cosmic-pi-deprecated/Version2-HARDWARE/README.md

# Version2-HARDWARE
A single board version of Cosmic Pi building on the V2.5 analogue + main boards.
