cosmic-pi-deprecated/Version2-HARDWARE/BOM master with extended info.xlsx

Designator | Manufacturer Part Number | Quantity | Alternative | Comments | Package | Value | Voltage | Tolerance
SIPM1X1_BOT, SIPM1X1_TOP | ASD-NUV1S-P | 2 | ASD-NUV1C-P | DNP | DIODE_ASD-NUV1S-P
SIPM3X3_BOT, SIPM3X3_TOP | ASD-NUV3S-P | 2 |  | DNP | DIODE_ASD-NUV3S-P
R31 | RC0603JR-070RL | 1 |  |  | R0603 | 0 |  | N/A
R9 | RC1206JR-070RL | 1 |  |  | R1206 | 0 |  | N/A
L1 | 744235601 | 1 |  |  | WE-CNSW_1812 | 1 uH CM choke
R30, R66, R75 | RC0603JR-0710RL | 3 |  |  | R0603 | 10 |  | 5%
R64, R73 | RC0603JR-07100RL | 2 |  |  | R0603 | 100 |  | 5%
R5, R25, R40, R41, R56, R57, R60, R61 | RC0603FR-07100KL | 8 |  |  | R0603 | 100k |  | 1%
C9, C10, C14, C15, C19, C20, C24, C25, C29, C32, C33, C34, C35, C36, C38, C41, C44, C50, C53, C56, C57, C58, C59, C61, C65, C66, C73, C74, C76, C80, C81, C82, C84, C85, C86, C88, C90, C91, C92, C93, C94 | CC0603KRX7R9BB104 | 41 |  |  | C0603 | 100n | 50V
C1, C16 | ECP-U1C104MA5 | 2 |  |  | C0805 | 100n ECPU | 16V
C6 | TAJC107K010RNJ | 1 |  |  | C/6032-28R | 100u | 10V
USB1 | 10118193-0001LF | 1 |  |  | MICRO-USB5+6P-SMD-0.65-B | 10118193-0001LF
R4, R32, R67, R68 | ERA-6AEB103V | 4 |  |  | R0805 | 10K |  | 0.10%
R13, R14 | RC0603FR-0710KL | 2 |  |  | R0603 | 10K |  | 1%
R23, R29, R38, R39, R43, R53, R54, R55, R58, R59, R62, R63 | RC0603FR-0710KL | 12 |  |  | R0603 | 10k |  | 1%
C5, C8, C37, C39, C42, C51, C54, C60, C62, C48 | CC0603KRX7R9BB103 | 10 |  |  | C0603 | 10n | 50V
C26, C28, C67, C68 | CC0603KRX5R6BB106 | 4 |  |  | C0603 | 10u | 10V
C45, C47 | TAJA106K016RNJ | 2 |  |  | AVX | 10u | 16V
L11 | SRR0604-100ML | 1 |  |  | SRR0604 | 10u SRR0604-100ML
X4, X5 | 20021121-00008C4LF | 2 |  |  | 1296-08 | 1296-T08
L2, L9 | CM453232-151KL | 2 |  |  | L1812 | 150uH
R17, R26 | RC0603FR-071KL | 2 |  |  | R0603 | 1K |  | 1%
R21, R49 | RC0603FR-071ML | 2 |  |  | R0603 | 1M |  | 1%
R71, R77 | RC0603FR-071KL | 2 |  |  | R0603 | 1k |  | 1%
R1, R2, R15, R16 | RC1206FR-071KL | 4 |  |  | R1206 | 1k |  | 1%
C43, C49, C63, C64, C72, C75 | CC0603KRX7R9BB102 | 6 |  |  | C0603 | 1n | 50V
C7, C13, C83, C95 | CC0603KRX7R8BB105 | 4 |  |  | C0603 | 1u | 25V
C2, C3, C21, C22 | CL31B105KCHNNNE | 4 |  |  | C1206 | 1u | 100V
C11 | CC0603KRX7R6BB225 | 1 |  |  | C0603 | 2.2u | 10V
R7, R8 | RC0603JR-0720RL | 2 |  |  | R0603 | 20 |  | 5%
R42, R52 | RC0603JR-07200KL | 2 |  |  | R0603 | 200k |  | 5%
C77, C78 | CL10C200JB8NNNC | 2 |  |  | C0603 | 20p | 50V
C40, C52, C55 | CC0603KRX7R8BB224 | 3 |  |  | C0603 | 220n | 25V
IC11 | 24LC00T-I/OT | 1 |  |  | SOT23-5L | 24C00OT
X2 | GX531S-8.000KKF1001 | 1 |  |  | X5032_4P | 306010032_XTAL_8MHZ_5032_4P
R18, R27 | RC0603FR-0730KL | 2 |  |  | R0603 | 30K |  | 1%
C4, C17 | 06031A300J4T2A | 2 |  |  | C0603 | 30p NP0 | 100V
CPU, PSU | STM32F401RET6 | 2 |  |  | LQFP64 | 310010495_STM32F401RET6
R11, R50 | RC0603FR-0730KL | 2 |  |  | R0603 | 32.4k |  | 1%
R3, R22, R34, R35, R45 | RC0603FR-07330RL | 5 |  |  | R0603 | 330 |  | 1%
R36, R37 | RC0603FR-07330RL | 2 |  |  | R0603 | 330R |  | 1%
C27, C71, C79, C87, C89 | CC0603KRX5R6BB475 | 5 |  |  | C0603 | 4.7u | 10V
C12, C46 | CC0402KRX7R8BB473 | 2 |  |  | C0603 | 47n | 25V
L3 | B82496C3470J000 | 1 |  |  | INDC1608X90N | 47nH
PC1, PC2 | EEE-HA1E470WP | 2 |  |  | PANASONIC_D | 47u | 25V
J3, J4, J5 | 5-1814400-1 | 3 |  | Bottom side | TE_5-1814400-1 | 5-1814400-1
R65, R74 | CRCW0603499KFKEA | 2 |  | Actually 499k | R0603 | 500k |  | 1%
R24, R28 | RC0603FR-07510RL | 2 |  |  | R0603 | 5100 |  | 1%
R19 | RC0603JR-0751KL | 1 |  |  | R0603 | 51K |  | 5%
L4, L5, L6, L7, L8 | 74279218 | 5 |  |  | 1206 | 600R/100MHz
IC7, IC8, IC9 | SN74LVC1G00DBVR | 3 |  |  | SOT23-5 | SN74LVC1G00DBVR
R10, R12, R20, R47 | CRCW0603820RFKEA | 4 |  |  | R0603 | 820 |  | 1%
IC1, IC2, IC10 | AD8039ARZ | 3 |  |  | SO8 | AD8039
D3, D4 | BAS70-04-E3-08 | 2 |  |  | SOT23 | BAS70-04
D13, D14 | BAT46WH | 2 |  |  | SOD123F | BAT46WH
D10, D12 | BL-HB337A-AV-TRB | 2 |  | Any 0402 blue LED is ok. | LED-0402 | BLUE-0402
D1 | 19-217-BHC-ZL1M2RY-3T | 1 |  | Any 0603 blue LED is ok. | LED-0603 | BLUE-0603
Q1, Q2 | BSS123-7-F | 2 |  |  | SOT23 | BSS123
D6 | CD1206-S01575 | 1 |  |  | MINIMELF | CD1206-S01575
J6 | M20-7871042 | 1 | 2-969973-0 | Top side | 2X20_SHROUDED_SMT | CONN_20X2SHROUDED_SMT
D9, D11 | 19-217-G7C-AN1P2-3T | 2 |  | Any 0603 green LED is ok | LED-0603 | GREEN-0603
U1 | L76-M33 | 1 |  | Supplier - RS | CAPCAV110P970X1010X250-18N | L76-M33
IC13 | LM2734YMK/NOPB | 1 |  |  | SOT23-6 | LM2734Y
IC4, IC5, IC6 | TLC555ID | 3 |  |  | SO08 | LM555D
IC3 | LP2985IM5-3.1 | 1 |  |  | SOT95P284X120-5N | LP2985IM5-3.1
IC14 | LPS25HBTR | 1 |  |  | LPS25H | LPS25H
IC16 | LSM303DTR | 1 |  |  | LGA16L | LSM303D
IC$3 | MAX991ESA+ | 1 |  |  | SOIC-8 | MAX991ESA+
U3, U4 | MCP4725A0T-E/CH | 2 |  |  | SOT23-6 | MCP4725
L10 | MH2029-300Y | 1 |  |  | 805 | MH2029-300Y
IC12 | NCP1117ST33T3G | 1 |  |  | SOT223 | NCP1117ST33T3G -3V3
X1 | DC-005 | 1 |  | Bottom side | POWERSUPPLY_DC-21MM | POWERSUPPLY_DC21MMX
IC15 | Si7006-A20-IM1 | 1 |  |  | 3X3DFN | SI7006A20
D7, D8, D15 | SS1P3L-M3/84A | 3 |  |  | DO220AAL | SS1P3L
IC17 | UCC27528D | 1 |  |  | ANALOG-DEVICES_SO8 | UCC27528UCC27528DR
