cosmic-pi-deprecated/Version2-HARDWARE/Cosmic Pi V2.pdf

# Signal

# +4V Regulated Power Supply

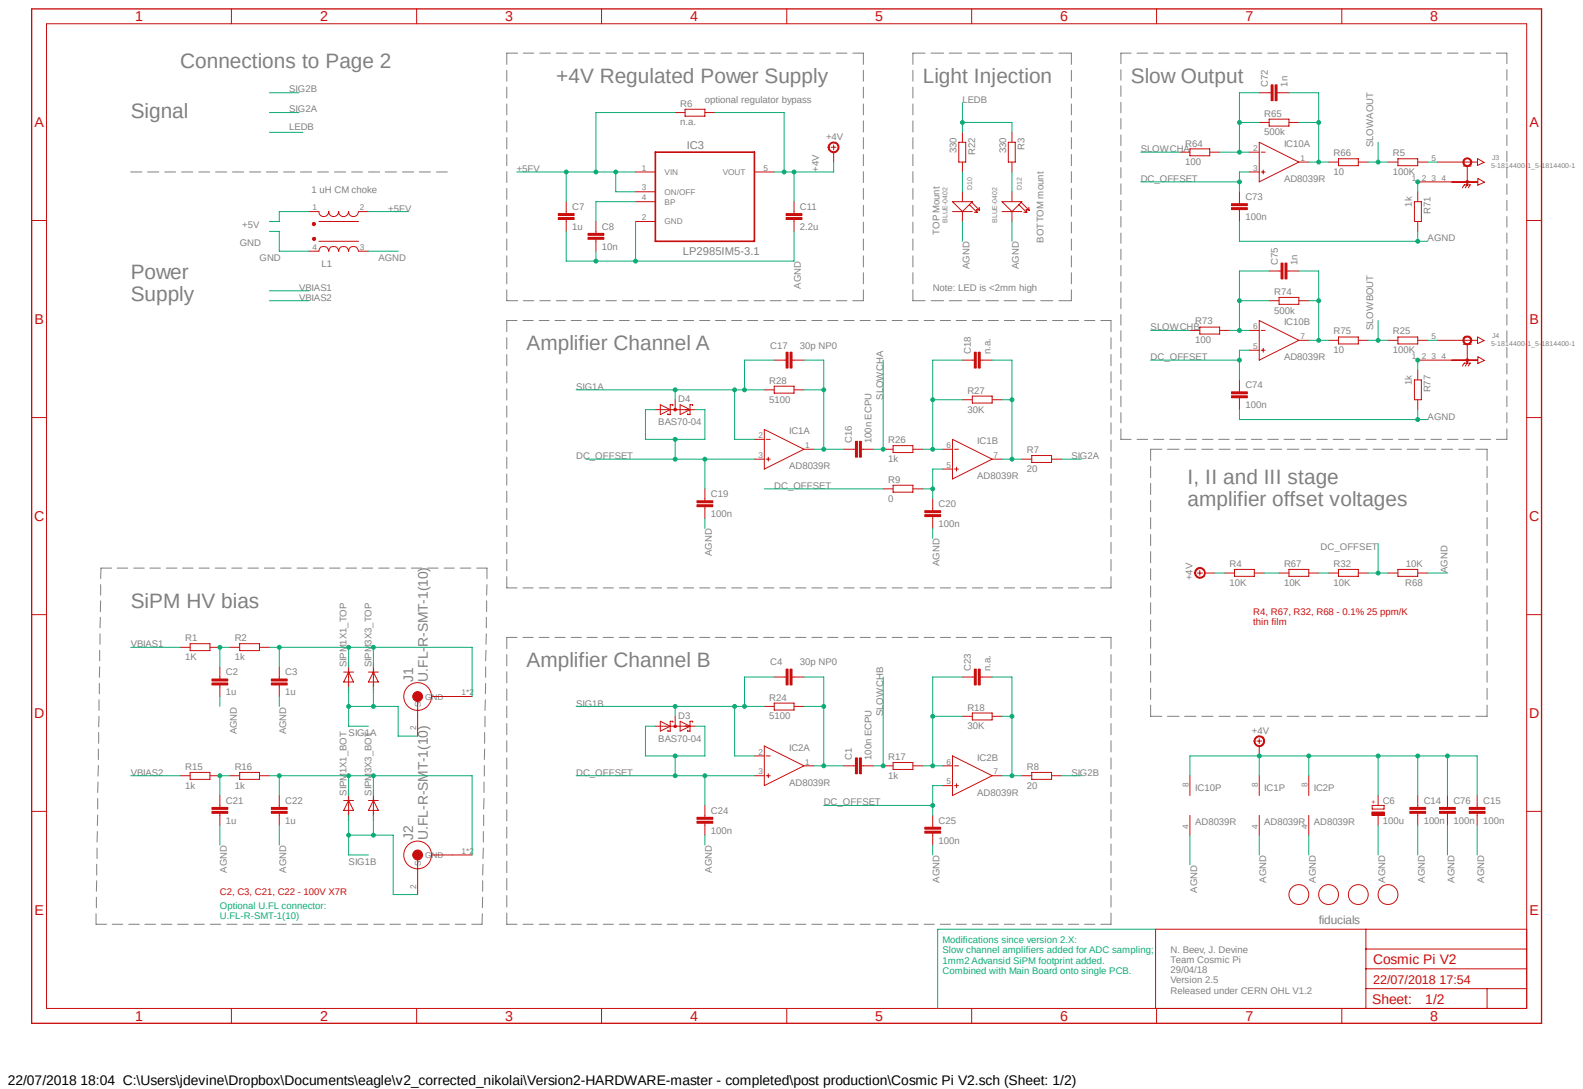
[picture p1: page 1]

I, II and III stage
amplifier offset voltages

U.FL-R-SMT-1(10)

22/07/2018 18:04 C:\Users\jdevine\Dropbox\Documents\eagle\v2_corrected_nikolai\Version2-HARDWARE-master - completed\post production\Cosmic Pi V2.sch (Sheet: 1/2) SpiceOrder 1 SpiceOrder 2 SpiceOrder 1 SpiceOrder 2 SpiceOrder 1 SpiceOrder 2 SpiceOrder 1 SpiceOrder 2

fiducials

Modifications since version 2.X:
Slow channel amplifiers added for ADC sampling;
1mm2 Advansid SiPM footprint added.
Combined with Main Board onto single PCB.

N. Beev, J. Devine Team Cosmic Pi 29/04/18 Version 2.5 Released under CERN OHL V1.2

Sheet: 1/2

A

A

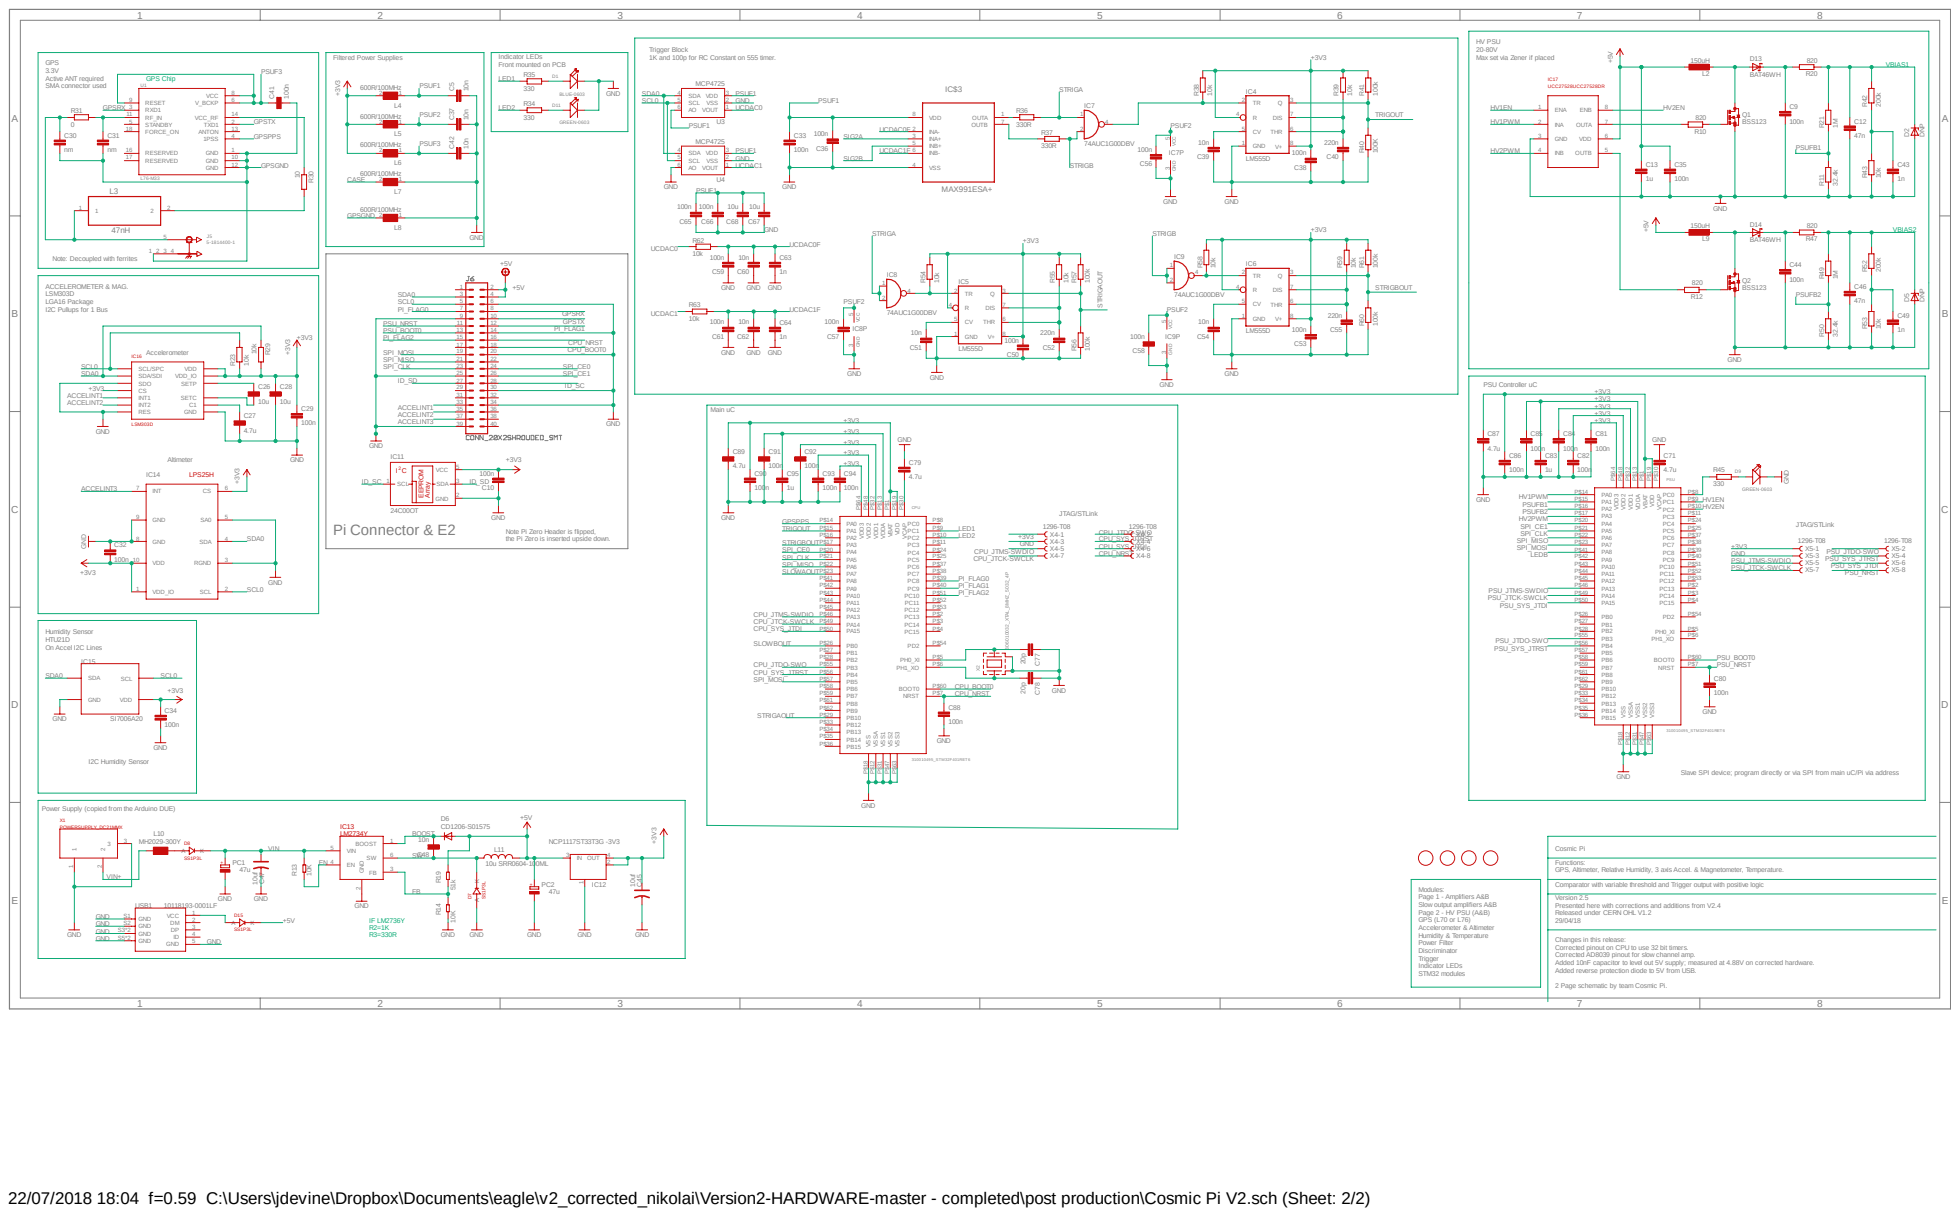
[picture p2: page 2]

HV PSU
Max set via Zener if placed

Indicator LEDs
Front mounted on PCB
LED1

Note: Decoupled with ferrites

GND
Note Pi Zero Header is flipped,
the Pi Zero is inserted upside down.

Slave SPI device; program directly or via SPI from main uC/Pi via address

Power Supply (copied from the Arduino DUE)

Cosmic Pi
Functions:
GPS, Altimeter, Relative Humidity, 3 axis Accel. & Magnetometer, Temperature.

Comparator with variable threshold and Trigger output with positive logic
Version 2.5
Presented here with corrections and additions from V2.4
Released under CERN OHL V1.2

Changes in this release:
Corrected pinout on CPU to use 32 bit timers.
Corrected AD8039 pinout for slow channel amp.
Added 10nF capacitor to level out 5V supply; measured at 4.88V on corrected hardware.
Added reverse protection diode to 5V from USB.

2 Page schematic by team Cosmic Pi.

22/07/2018 18:04 f=0.59 C:\Users\jdevine\Dropbox\Documents\eagle\v2_corrected_nikolai\Version2-HARDWARE-master - completed\post production\Cosmic Pi V2.sch (Sheet: 2/2)
