cosmic-pi-deprecated/Version2-HARDWARE/Cosmic Pi V2.brd

## EAGLE design Cosmic Pi V2.brd (2018-07-22)

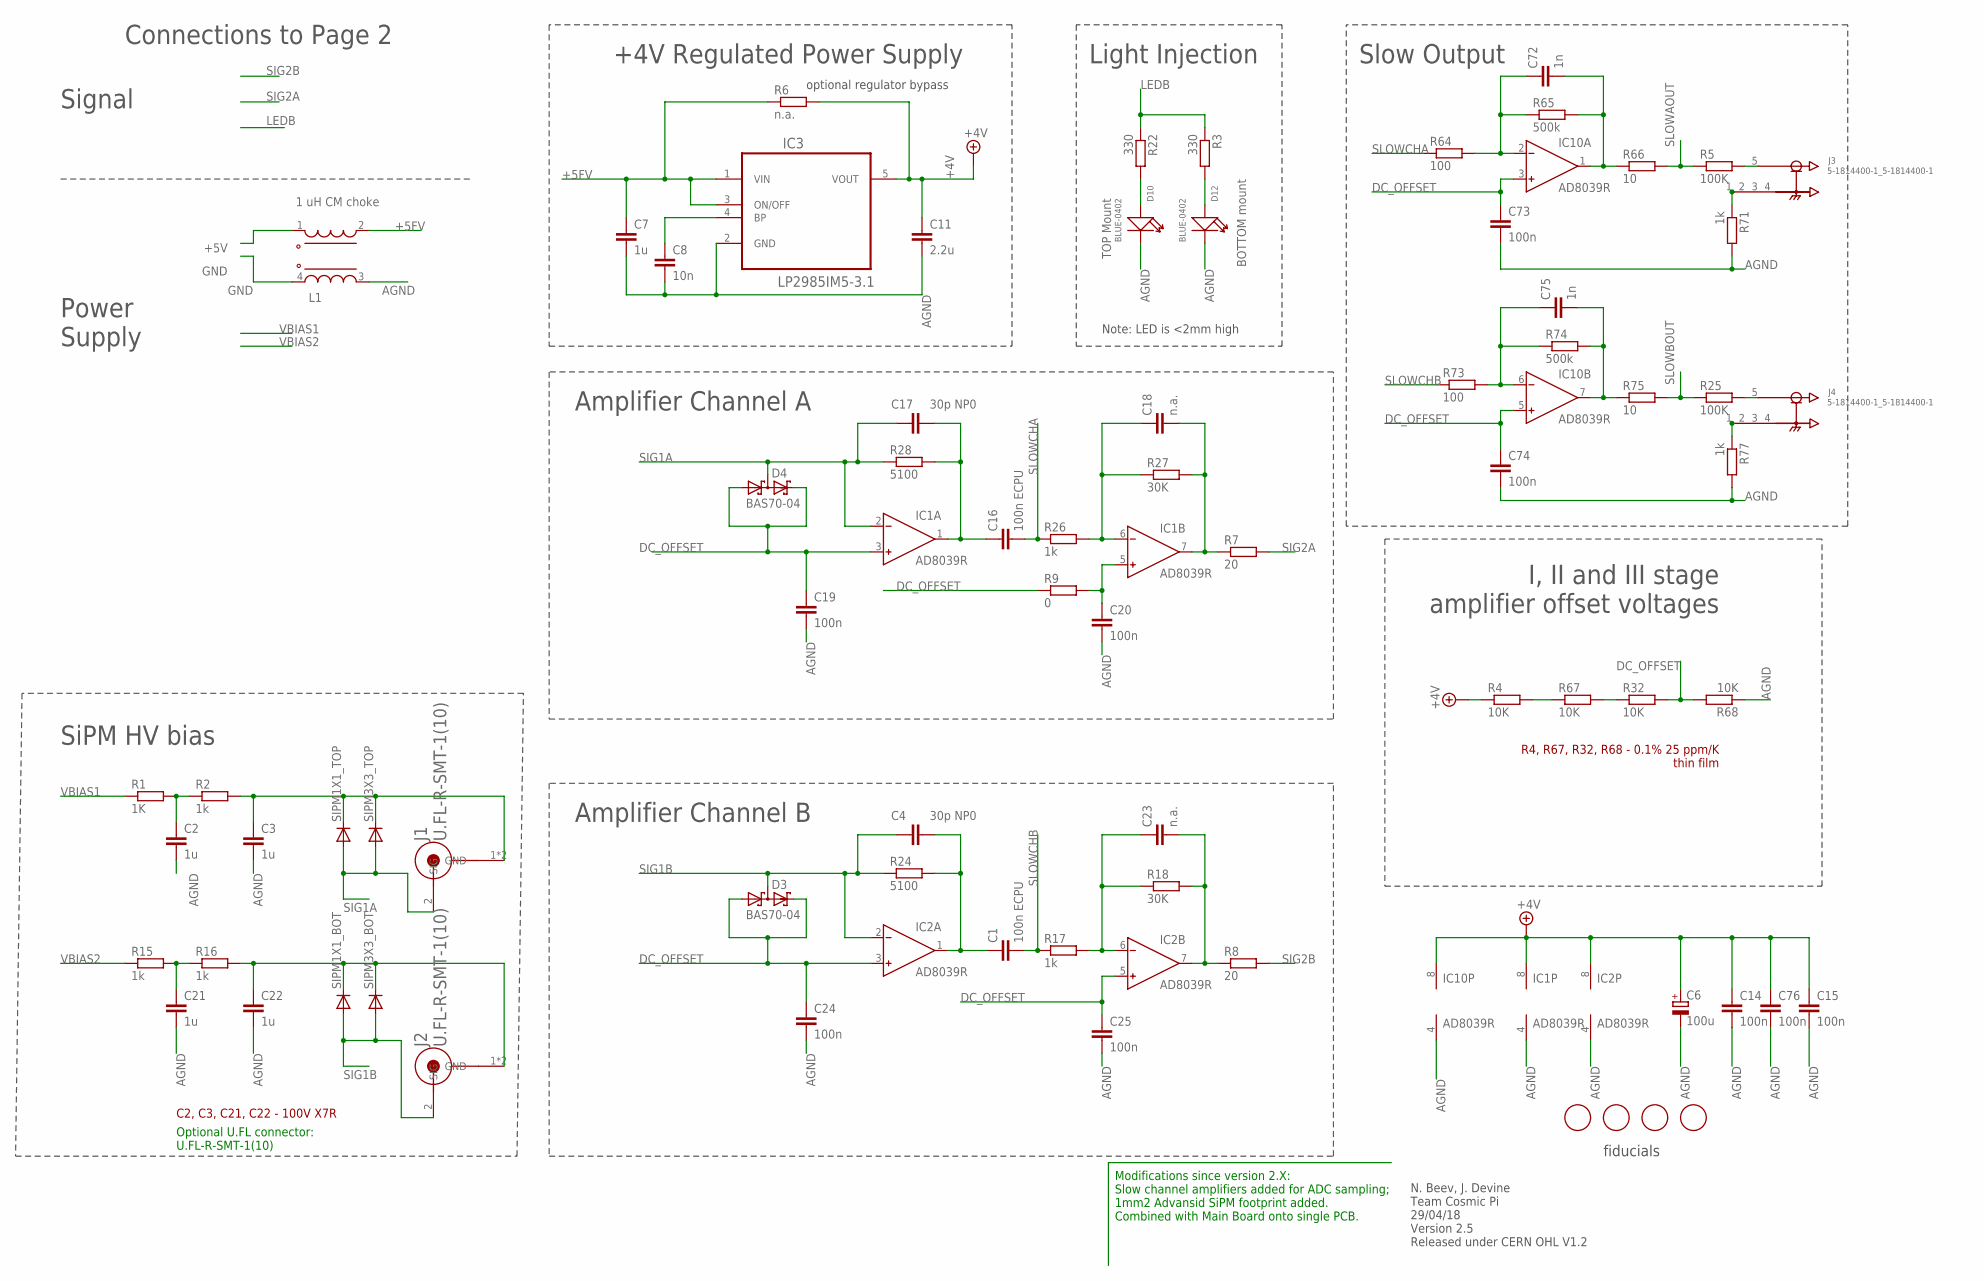
[picture p3: schematic Cosmic Pi V2.sch, sheet 1]

Parts:
C1, C16: 100n ECPU; C0805
C2, C3, C21, C22: 1u; C1206
C4, C17: 30p NP0; C0603
C6: 100u; C/6032-28R
C7: 1u; C0603
C8: 10n; C0603
C11: 2.2u; C0603
C14, C15, C19, C20, C24, C25, C73, C74, C76: 100n; C0603
C18, C23: n.a.; C0603
C72, C75: 1n; C0603
D3, D4: BAS70-04; SOT23
D10, D12: BLUE-0402; LED-0402
IC1, IC2, IC10: AD8039R; SO8
IC3: LP2985IM5-3.1; SOT95P284X120-5N
J1, J2: U.FL-R-SMT-1(10); HRS_U.FL-R-SMT-1(10)
J3, J4: 5-1814400-1_5-1814400-1; 5-1814400-1_TE_5-1814400-1
L1: 1 uH CM choke; WE-CNSW_1812
R1: 1K; R1206
R2, R15, R16: 1k; R1206
R3, R22: 330; R0603
R4, R32, R67, R68: 10K; R0805
R5, R25: 100K; R0603
R6: n.a.; R0603
R7, R8: 20; R0603
R9: 0; R1206
R17, R26, R71, R77: 1k; R0603
R18, R27: 30K; R0603
R24, R28: 5100; R0603
R64, R73: 100; R0603
R65, R74: 500k; R0603
R66, R75: 10; R0603
SIPM1X1_BOT, SIPM1X1_TOP: DIODE_DIODE-ADVANSID1X1; DIODE_ASD-NUV1S-P
SIPM3X3_BOT, SIPM3X3_TOP: DIODE_DIODE-ADVANSID3X3; DIODE_ASD-NUV3S-P
U$2, U$3, U$4, U$5: FIDUCIAL; FIDUCIAL_1MM

Connections:
+4V: C6.+, C11.1, C14.1, C15.1, C76.1, IC1.8 (V+), IC2.8 (V+), IC3.5 (VOUT), IC10.8 (V+), R4.1, R6.2
+5FV: C7.1, IC3.1 (VIN), IC3.3 (ON/OFF), L1.2 (3), R6.1
+5V: L1.1 (4); also elsewhere on the board
AGND: C2.2, C3.2, C6.-, C7.2, C8.2, C11.2, C14.2, C15.2, C19.2, C20.2, C21.2, C22.2, C24.2, C25.2, C73.2, C74.2, C76.2, D10.-, D12.-, IC1.4 (V-), IC2.4 (V-), IC3.2 (GND), IC10.4 (V-), L1.3 (2), R68.1, R71.2, R77.2
DC_OFFSET: C19.1, C24.1, C25.1, C73.1, C74.1, D3.1 (A1), D3.2 (C2), D4.1 (A1), D4.2 (C2), IC1.3 (IN+), IC2.3 (IN+), IC2.5 (IN+), IC10.3 (IN+), IC10.5 (IN+), R9.1, R32.2, R68.2
GND: L1.4 (1); also elsewhere on the board
LEDB: R3.1, R22.1; also elsewhere on the board
unnamed: J3.5 (SIG), R5.2
unnamed: R4.2, R67.1
unnamed: D12.+, R3.2
unnamed: C8.1, IC3.4 (BP)
unnamed: C21.1, R15.2, R16.1
unnamed: C18.2, IC1.7 (OUT), R7.1, R27.2
unnamed: C22.1, J2.1 (GND), J2.3 (GND), R16.2, SIPM1X1_BOT.P$1 (C), SIPM3X3_BOT.P$1 (C)
unnamed: J4.5 (SIG), R25.2
unnamed: C23.2, IC2.7 (OUT), R8.1, R18.2
unnamed: C2.1, R1.2, R2.1
unnamed: C72.1, IC10.2 (IN-), R64.2, R65.1
unnamed: C20.1, IC1.5 (IN+), R9.2
unnamed: C3.1, J1.1 (GND), J1.3 (GND), R2.2, SIPM1X1_TOP.P$1 (C), SIPM3X3_TOP.P$1 (C)
unnamed: D10.+, R22.2
unnamed: R32.1, R67.2
unnamed: C1.1, C4.2, IC2.1 (OUT), R24.2
unnamed: J4.1 (GND), R77.1
unnamed: C23.1, IC2.6 (IN-), R17.2, R18.1
unnamed: C16.1, C17.2, IC1.1 (OUT), R28.2
unnamed: C72.2, IC10.1 (OUT), R65.2, R66.1
unnamed: C18.1, IC1.6 (IN-), R26.2, R27.1
unnamed: C75.1, IC10.6 (IN-), R73.2, R74.1
unnamed: J3.1 (GND), R71.1
unnamed: C75.2, IC10.7 (OUT), R74.2, R75.1
SIG1A: C17.1, D4.3 (C1A2), IC1.2 (IN-), J1.2 (SIG), R28.1, SIPM1X1_TOP.P$2 (A), SIPM3X3_TOP.P$2 (A)
SIG1B: C4.1, D3.3 (C1A2), IC2.2 (IN-), J2.2 (SIG), R24.1, SIPM1X1_BOT.P$2 (A), SIPM3X3_BOT.P$2 (A)
SIG2A: R7.2; also elsewhere on the board
SIG2B: R8.2; also elsewhere on the board
SLOWAOUT: R5.1, R66.2; also elsewhere on the board
SLOWBOUT: R25.1, R75.2; also elsewhere on the board
SLOWCHA: C16.2, R26.1, R64.1
SLOWCHB: C1.2, R17.1, R73.1
VBIAS1: R1.1; also elsewhere on the board
VBIAS2: R15.1; also elsewhere on the board

Notes on the sheet:
N. Beev, J. Devine Team Cosmic Pi 29/04/18 Version 2.5 Released under CERN OHL V1.2
Signal
Power Supply
Note: LED is <2mm high
+4V Regulated Power Supply
Amplifier Channel A
Amplifier Channel B
SiPM HV bias
optional regulator bypass
Light Injection
I, II and III stage amplifier offset voltages
fiducials
R4, R67, R32, R68 - 0.1% 25 ppm/K thin film
C2, C3, C21, C22 - 100V X7R
Optional U.FL connector: U.FL-R-SMT-1(10)
Modifications since version 2.X: Slow channel amplifiers added for ADC sampling; 1mm2 Advansid SiPM footprint added. Combined with Main Board onto single PCB.
Connections to Page 2
Slow Output

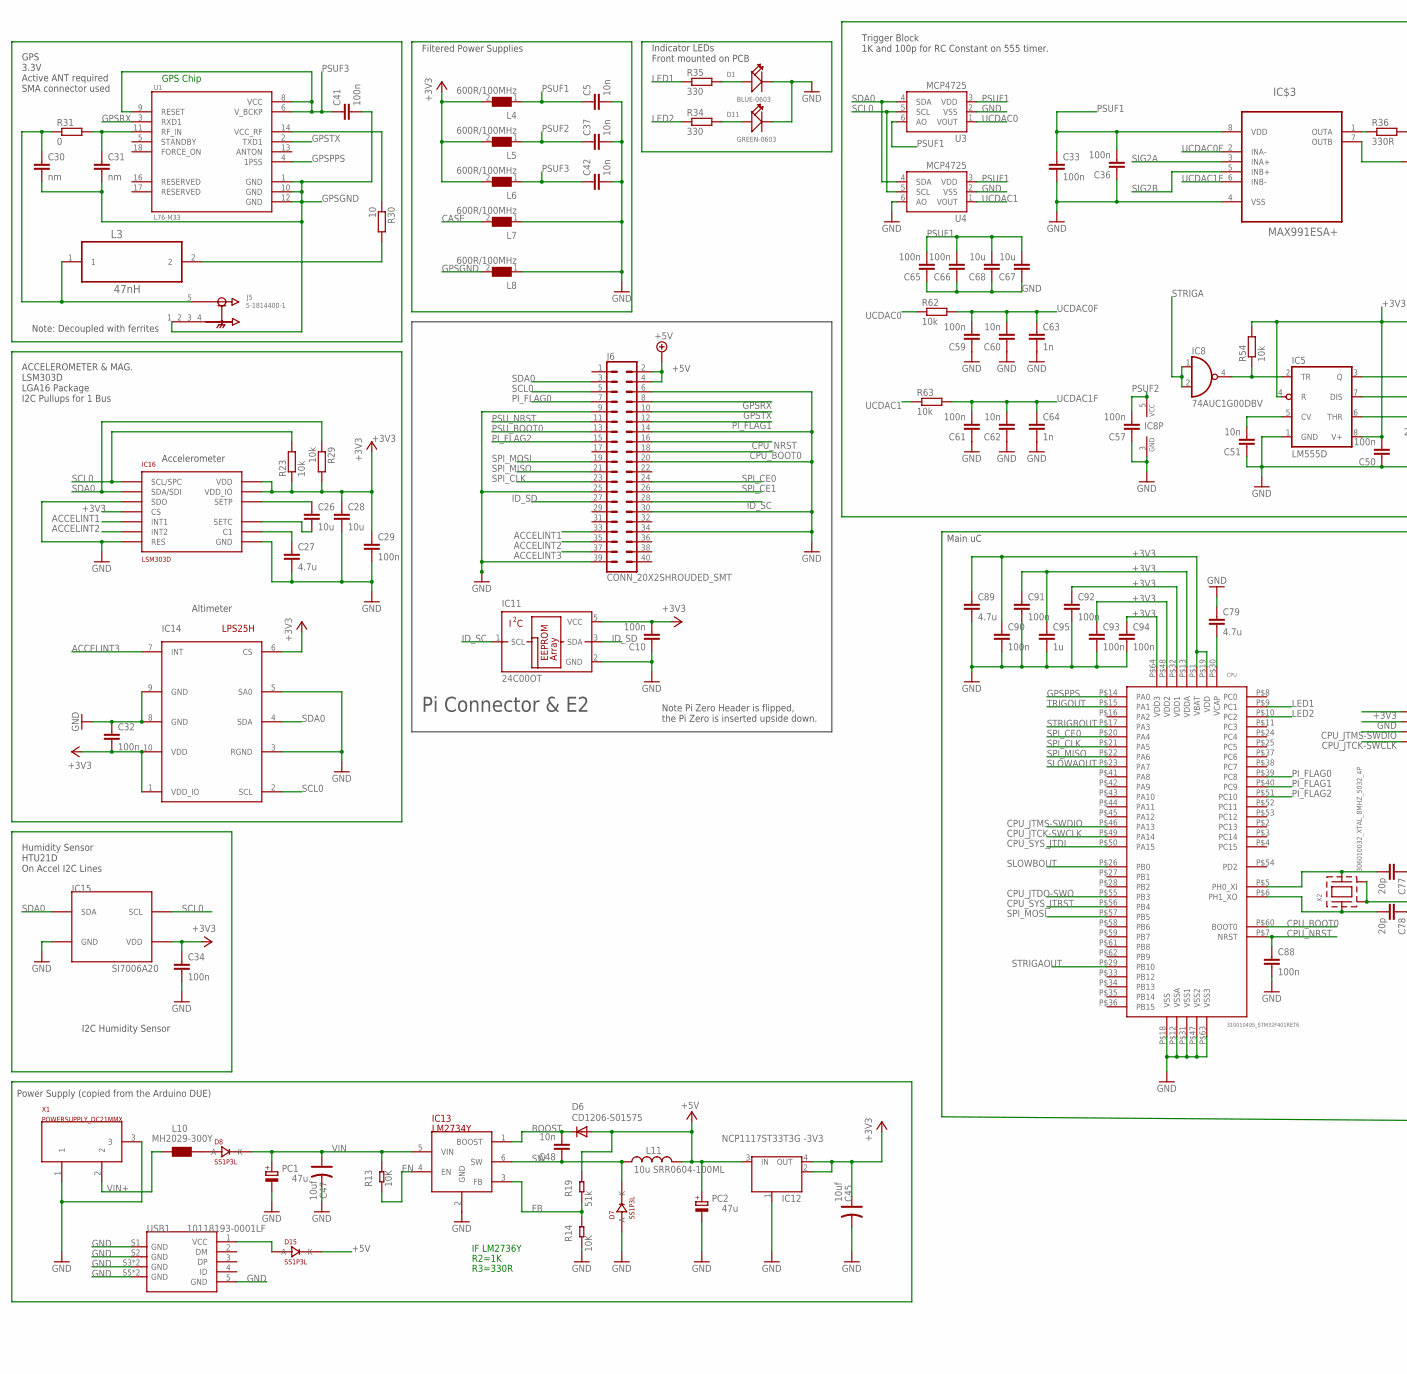
[picture p4: schematic Cosmic Pi V2.sch, sheet 2, part in row 1, column 1]

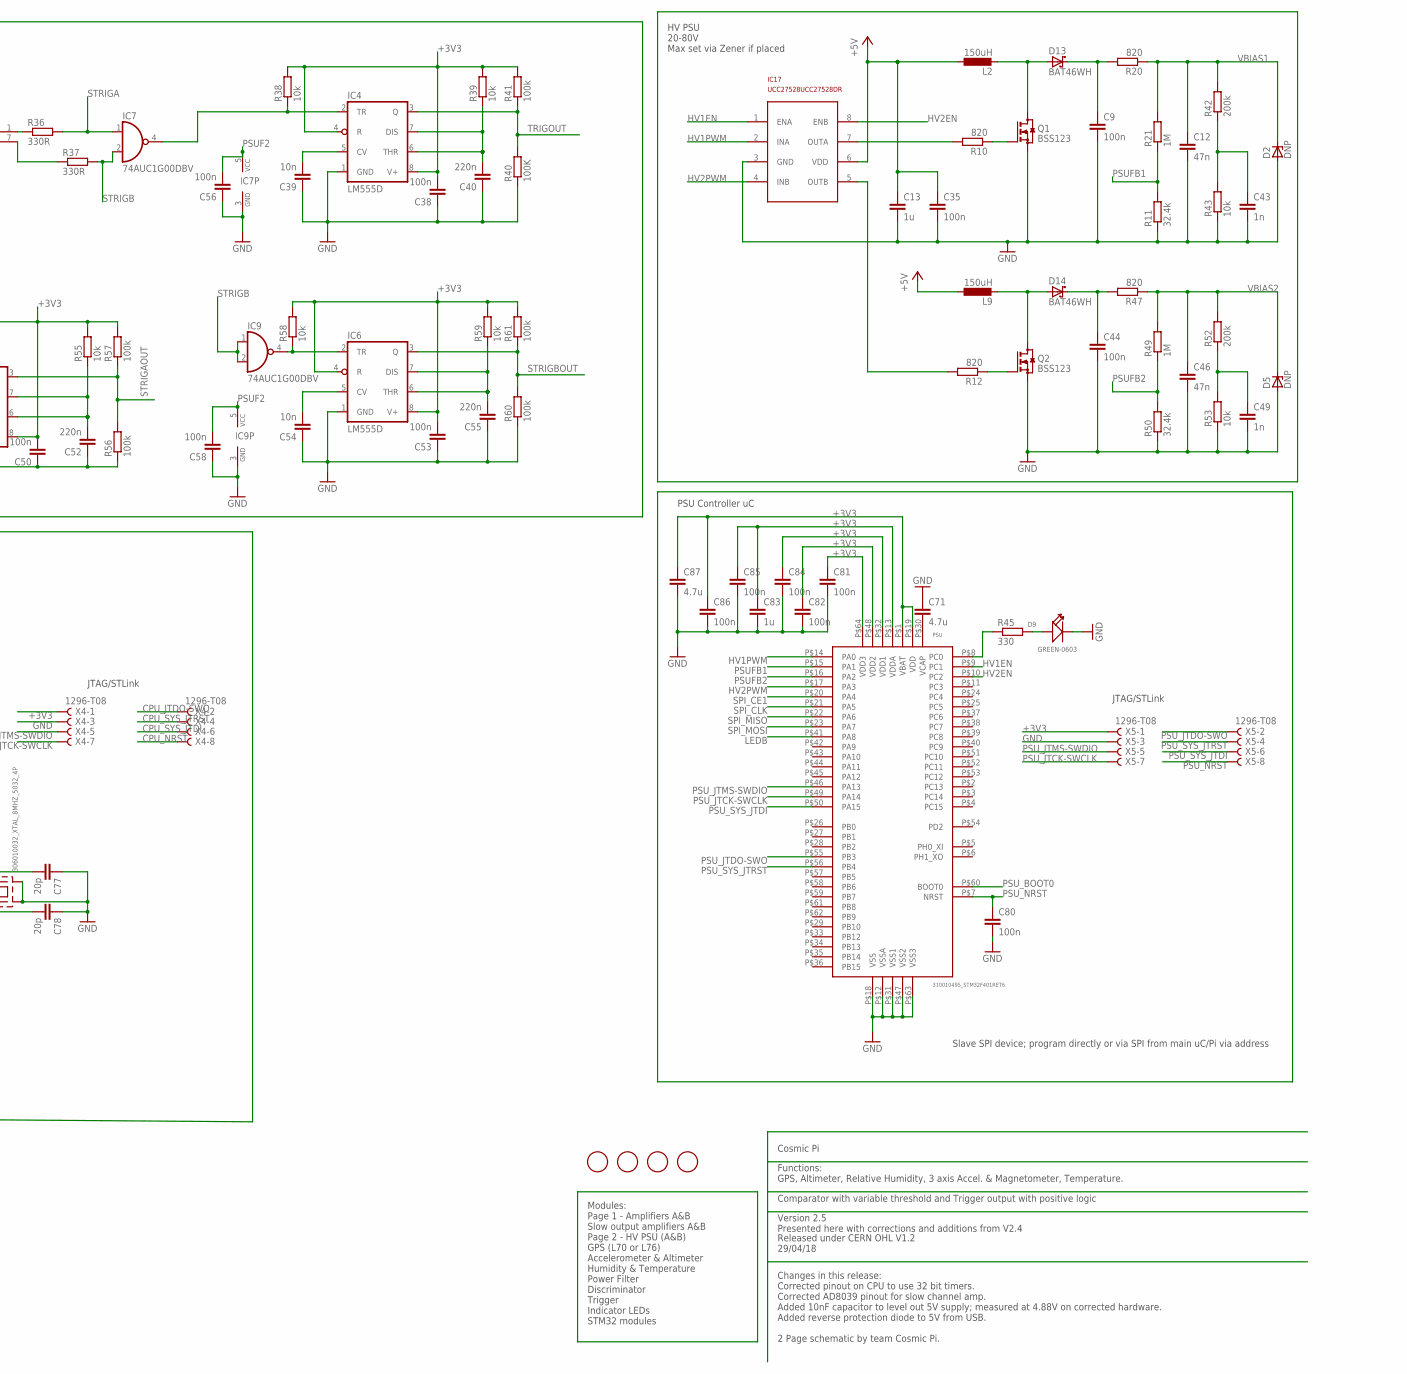
[picture p5: schematic Cosmic Pi V2.sch, sheet 2, part in row 1, column 2]

Parts:
C5, C37, C39, C42, C48, C51, C54, C60, C62: 10n; C0603
C9, C10, C29, C32, C33, C34, C35, C36, C38, C41, C44, C50, C53, C56, C57, C58, C59, C61, C65, C66, C80, C81, C82, C84, C85, C86, C88, C90, C91, C92, C93, C94: 100n; C0603
C12, C46: 47n; C0603
C13, C83, C95: 1u; C0603
C26, C28, C67, C68: 10u; C0603
C27, C71, C79, C87, C89: 4.7u; C0603
C30, C31: nm; C0603
C40, C52, C55: 220n; C0603
C43, C49, C63, C64: 1n; C0603
C45, C47: 10uf; AVX-A
C77, C78: 20p; C0603
CPU: 310010495_STM32F401RET6; LQFP64
D1: BLUE-0603; LED-0603
D2, D5: DNP; SOT23
D6: CD1206-S01575; MINIMELF
D7, D8, D15: SS1P3L; DO220AAL
D9, D11: GREEN-0603; LED-0603
D13, D14: BAT46WH; SOD123F
IC4, IC5, IC6: LM555D; SO08
IC7, IC8, IC9: 74AUC1G00DBV; SOT23-5
IC11: 24C00OT; SOT23-5L
IC12: NCP1117ST33T3G -3V3; SOT223
IC13: LM2734Y; SOT23-6
IC14: LPS25H
IC15: SI7006A20; 3X3DFN
IC16: LSM303D; LGA16L
IC17: UCC27528UCC27528DR; ANALOG-DEVICES_SO8
IC$3: MAX991ESA+; SOIC-8
J5: 5-1814400-1; TE_5-1814400-1
J6: CONN_20X2SHROUDED_SMT; 2X20_SHROUDED_SMT
L2, L9: 150uH; L1812
L3: 47nH; INDC1608X90N
L4, L5, L6, L7, L8: 600R/100MHz; 1206
L10: MH2029-300Y; 0805
L11: 10u SRR0604-100ML; SRR0604
PC1, PC2: 47u; PANASONIC_D
PSU: 310010495_STM32F401RET6; LQFP64
Q1, Q2: BSS123; SOT23
R10, R12, R20, R47: 820; R0603
R11, R50: 32.4k; R0603
R13, R14: 10K; R0603
R19: 51k; R0603
R21, R49: 1M; R0603
R23, R29, R38, R39, R43, R53, R54, R55, R58, R59, R62, R63: 10k; R0603
R30: 10; R0603
R31: 0; R0603
R34, R35, R45: 330; R0603
R36, R37: 330R; R0603
R40: 100K; R0603
R41, R56, R57, R60, R61: 100k; R0603
R42, R52: 200k; R0603
U1: L76-M33; CAPCAV110P970X1010X250-18N
U3, U4: MCP4725; SOT23-6
U$1, U$6, U$7, U$8: FIDUCIAL; FIDUCIAL_1MM
USB1: 10118193-0001LF; MICRO-USB5+6P-SMD-0.65-B
X1: POWERSUPPLY_DC21MMX; POWERSUPPLY_DC-21MM
X2: 306010032_XTAL_8MHZ_5032_4P; X5032_4P
X4, X5: 1296-T08; 1296-08

Connections:
+3V3: C10.2, C28.1, C29.1, C32.2, C34.1, C38.2, C45.+, C50.2, C53.2, C81.1, C82.1, C83.1, C84.1, C85.1, C86.1, C87.1, C89.1, C90.1, C91.1, C92.1, C93.1, C94.1, C95.1, CPU.P$1 (VBAT), CPU.P$13 (VDDA), CPU.P$19 (VDD), CPU.P$32 (VDD1), CPU.P$48 (VDD2), CPU.P$64 (VDD3), IC4.4 (R), IC4.8 (V+), IC5.4 (R), IC5.8 (V+), IC6.4 (R), IC6.8 (V+), IC11.5 (VCC), IC12.2 (OUT), IC12.4 (OUT), IC14.1 (VDD_IO), IC14.6 (CS), IC14.10 (VDD), IC15.P$5 (VDD), IC16.P$1 (VDD_IO), IC16.P$8 (CS), IC16.P$14 (VDD), L4.2, L5.2, L6.2, PSU.P$1 (VBAT), PSU.P$13 (VDDA), PSU.P$19 (VDD), PSU.P$32 (VDD1), PSU.P$48 (VDD2), PSU.P$64 (VDD3), R23.1, R29.2, R38.2, R39.2, R41.2, R54.2, R55.2, R57.2, R58.2, R59.2, R61.2, X4.1, X5.1
+5V: C13.1, C35.1, D6.A, D15.P$1 (K), IC12.3 (IN), IC17.6 (VDD), J6.2, J6.4, L2.1, L9.1, L11.P$2 (2), PC2.+, R19.1; also elsewhere on the board
ACCELINT1: IC16.P$11 (INT1), J6.33
ACCELINT2: IC16.P$9 (INT2), J6.35
ACCELINT3: IC14.7 (INT), J6.37
BOOST: C48.2, D6.C, IC13.1 (BOOST)
CASE: L7.2
CPU_BOOT0: CPU.P$60 (BOOT0), J6.18
CPU_JTCK-SWCLK: CPU.P$49 (PA14), X4.7
CPU_JTDO-SWO: CPU.P$55 (PB3), X4.2
CPU_JTMS-SWDIO: CPU.P$46 (PA13), X4.5
CPU_NRST: C88.1, CPU.P$7 (NRST), J6.16, X4.8
CPU_SYS_JTDI: CPU.P$50 (PA15), X4.6
CPU_SYS_JTRST: CPU.P$56 (PB4), X4.4
EN: IC13.4 (EN), R13.2
FB: IC13.3 (FB), R14.1, R19.2
GND: C5.2, C9.2, C10.1, C12.2, C13.2, C27.2, C28.2, C29.2, C32.1, C33.2, C34.2, C35.2, C36.1, C37.2, C38.1, C39.1, C40.1, C42.2, C43.2, C44.2, C45.-, C46.2, C47.-, C49.2, C50.1, C51.1, C52.1, C53.1, C54.1, C55.1, C56.1, C57.1, C58.1, C59.1, C60.1, C61.1, C62.1, C63.2, C64.2, C65.1, C66.1, C67.1, C68.1, C71.1, C77.1, C78.1, C79.1, C80.2, C81.2, C82.2, C83.2, C84.2, C85.2, C86.2, C87.2, C88.2, C89.2, C90.2, C91.2, C92.2, C93.2, C94.2, C95.2, CPU.P$12 (VSSA), CPU.P$18 (VSS), CPU.P$31 (VSS1), CPU.P$47 (VSS2), CPU.P$63 (VSS3), D1.-, D2.1 (A), D5.1 (A), D7.P$2 (A), D9.-, D11.-, IC4.1 (GND), IC5.1 (GND), IC6.1 (GND), IC7.3 (GND), IC8.3 (GND), IC9.3 (GND), IC11.2 (GND), IC12.1 (GND/ADJ), IC13.2 (GND), IC14.3 (RGND), IC14.5 (SA0), IC14.8 (GND), IC14.9 (GND), IC15.P$2 (GND), IC16.P$5 (GND), IC16.P$7 (SDO), IC16.P$10 (RES), IC16.P$12 (GND), IC16.P$13 (GND), IC16.P$16 (GND), IC17.3 (GND), IC$3.4 (VSS), J6.6, J6.9, J6.14, J6.20, J6.25, J6.30, J6.34, J6.39, L7.1, L8.1, PC1.-, PC2.-, PSU.P$12 (VSSA), PSU.P$18 (VSS), PSU.P$31 (VSS1), PSU.P$47 (VSS2), PSU.P$63 (VSS3), Q1.2 (S), Q2.2 (S), R11.1, R14.2, R40.1, R43.1, R50.1, R53.1, R56.1, R60.1, U3.2 (VSS), U4.2 (VSS), U4.6 (AO), USB1.5 (GND), USB1.S1 (GND), USB1.S2 (GND), USB1.S3 (GND), USB1.S4 (GND), USB1.S5 (GND), USB1.S6 (GND), X1.1, X1.3, X2.P$2 (GND1), X2.P$4 (GND2), X4.3, X5.3; also elsewhere on the board
GPSGND: C30.2, C31.2, C41.2, J5.1 (GND), L8.2, U1.1 (GND), U1.10 (GND), U1.12 (GND)
GPSPPS: CPU.P$14 (PA0), U1.4 (1PSS)
GPSRX: J6.8, U1.3 (RXD1)
GPSTX: J6.10, U1.2 (TXD1)
HV1EN: IC17.1 (ENA), PSU.P$9 (PC1)
HV1PWM: IC17.2 (INA), PSU.P$14 (PA0)
HV2EN: IC17.8 (ENB), PSU.P$10 (PC2)
HV2PWM: IC17.4 (INB), PSU.P$17 (PA3)
ID_SC: IC11.1 (SCL), J6.28
ID_SD: IC11.3 (SDA), J6.27
LED1: CPU.P$9 (PC1), R35.1
LED2: CPU.P$10 (PC2), R34.1
LEDB: PSU.P$41 (PA8); also elsewhere on the board
unnamed: D15.P$2 (A), USB1.1 (VCC)
unnamed: D13.2 (A), L2.2, Q1.3 (D)
unnamed: Q1.1 (G), R10.1
unnamed: C39.2, IC4.5 (CV)
unnamed: C40.2, IC4.6 (THR), IC4.7 (DIS), R39.1
unnamed: Q2.1 (G), R12.1
unnamed: D14.2 (A), L9.2, Q2.3 (D)
unnamed: C44.1, D14.1 (K), R47.2
unnamed: IC17.5 (OUTB), R12.2
unnamed: D9.+, R45.2
unnamed: PSU.P$8 (PC0), R45.1
unnamed: C51.2, IC5.5 (CV)
unnamed: C52.2, IC5.6 (THR), IC5.7 (DIS), R55.1
unnamed: C54.2, IC6.5 (CV)
unnamed: C55.2, IC6.6 (THR), IC6.7 (DIS), R59.1
unnamed: IC4.2 (TR), IC7.4 (O), R38.1
unnamed: IC6.2 (TR), IC9.4 (O), R58.1
unnamed: IC5.2 (TR), IC8.4 (O), R54.1
unnamed: IC$3.1 (OUTA), R36.1
unnamed: IC17.7 (OUTA), R10.2
unnamed: IC$3.7 (OUTB), R37.1
unnamed: C30.1, J5.5 (SIG), L3.1, R31.1
unnamed: D8.P$2 (A), L10.1
unnamed: C71.2, PSU.P$30 (VCAP)
unnamed: C26.1, IC16.P$3 (SETP)
unnamed: C26.2, IC16.P$2 (SETC)
unnamed: C27.1, IC16.P$15 (C1)
unnamed: L3.2, R30.2
unnamed: R30.1, U1.14 (VCC_RF)
unnamed: C31.1, R31.2, U1.11 (RF_IN)
unnamed: D1.+, R35.2
unnamed: D11.+, R34.2
unnamed: C9.1, D13.1 (K), R20.2
unnamed: C77.2, CPU.P$5 (PH0_XI), X2.P$3
unnamed: C78.2, CPU.P$6 (PH1_XO), X2.P$1
unnamed: C79.2, CPU.P$30 (VCAP)
PI_FLAG0: CPU.P$39 (PC8), J6.7
PI_FLAG1: CPU.P$40 (PC9), J6.12
PI_FLAG2: CPU.P$51 (PC10), J6.15
PSUF1: C5.1, C33.1, C36.2, C65.2, C66.2, C67.2, C68.2, IC$3.8 (VDD), L4.1, U3.3 (VDD), U3.6 (AO), U4.3 (VDD)
PSUF2: C37.1, C56.2, C57.2, C58.2, IC7.5 (VCC), IC8.5 (VCC), IC9.5 (VCC), L5.1
PSUF3: C41.1, C42.1, L6.1, U1.6 (V_BCKP), U1.8 (VCC), U1.9 (RESET)
PSUFB1: PSU.P$15 (PA1), R11.2, R21.1
PSUFB2: PSU.P$16 (PA2), R49.1, R50.2
PSU_BOOT0: J6.13, PSU.P$60 (BOOT0)
PSU_JTCK-SWCLK: PSU.P$49 (PA14), X5.7
PSU_JTDO-SWO: PSU.P$55 (PB3), X5.2
PSU_JTMS-SWDIO: PSU.P$46 (PA13), X5.5
PSU_NRST: C80.1, J6.11, PSU.P$7 (NRST), X5.8
PSU_SYS_JTDI: PSU.P$50 (PA15), X5.6
PSU_SYS_JTRST: PSU.P$56 (PB4), X5.4
SCL0: IC14.2 (SCL), IC15.P$6 (SCL), IC16.P$4 (SCL/SPC), J6.5, R23.2, U3.5 (SCL), U4.5 (SCL)
SDA0: IC14.4 (SDA), IC15.P$1 (SDA), IC16.P$6 (SDA/SDI), J6.3, R29.1, U3.4 (SDA), U4.4 (SDA)
SIG2A: IC$3.3 (INA+); also elsewhere on the board
SIG2B: IC$3.5 (INB+); also elsewhere on the board
SLOWAOUT: CPU.P$23 (PA7); also elsewhere on the board
SLOWBOUT: CPU.P$26 (PB0); also elsewhere on the board
SPI_CE0: CPU.P$20 (PA4), J6.24
SPI_CE1: J6.26, PSU.P$20 (PA4)
SPI_CLK: CPU.P$21 (PA5), J6.23, PSU.P$21 (PA5)
SPI_MISO: CPU.P$22 (PA6), J6.21, PSU.P$22 (PA6)
SPI_MOSI: CPU.P$57 (PB5), J6.19, PSU.P$23 (PA7)
STRIGA: IC7.1 (I0), IC8.1 (I0), IC8.2 (I1), R36.2
STRIGAOUT: CPU.P$29 (PB10), IC5.3 (Q), R56.2, R57.1
STRIGB: IC7.2 (I1), IC9.1 (I0), IC9.2 (I1), R37.2
STRIGBOUT: CPU.P$17 (PA3), IC6.3 (Q), R60.2, R61.1
SW: C48.1, D7.P$1 (K), IC13.6 (SW), L11.P$1 (1)
TRIGOUT: CPU.P$15 (PA1), IC4.3 (Q), R40.2, R41.1
UCDAC0: R62.1, U3.1 (VOUT)
UCDAC0F: C59.2, C60.2, C63.1, IC$3.2 (INA-), R62.2
UCDAC1: R63.1, U4.1 (VOUT)
UCDAC1F: C61.2, C62.2, C64.1, IC$3.6 (INB-), R63.2
VBIAS1: C12.1, D2.3 (C), R20.1, R21.2, R42.2; also elsewhere on the board
VBIAS2: C46.1, D5.3 (C), R47.1, R49.2, R52.2; also elsewhere on the board
VBIASFB1: C43.1, R42.1, R43.2
VBIASFB2: C49.1, R52.1, R53.2
VIN: C47.+, D8.P$1 (K), IC13.5 (VIN), PC1.+, R13.1
VIN+: L10.2, X1.2

Notes on the sheet:
Cosmic Pi
Functions: GPS, Altimeter, Relative Humidity, 3 axis Accel. & Magnetometer, Temperature.
Comparator with variable threshold and Trigger output with positive logic
Version 2.5 Presented here with corrections and additions from V2.4
Released under CERN OHL V1.2 29/04/18
2 Page schematic by team Cosmic Pi.
HV PSU 20-80V Max set via Zener if placed
GPS 3.3V Active ANT required SMA connector used
ACCELEROMETER & MAG. LSM303D LGA16 Package I2C Pullups for 1 Bus
Trigger Block 1K and 100p for RC Constant on 555 timer.
Filtered Power Supplies
Humidity Sensor HTU21D On Accel I2C Lines
Indicator LEDs Front mounted on PCB
Modules: Page 1 - Amplifiers A&B Slow output amplifiers A&B Page 2 - HV PSU (A&B) GPS (L70 or L76) Accelerometer & Altimeter Humidity & Temperature Power Filter Discriminator Trigger Indicator LEDs STM32 modules
Accelerometer
Altimeter
GPS Chip
I2C Humidity Sensor
Note: Decoupled with ferrites
Changes in this release: Corrected pinout on CPU to use 32 bit timers. Corrected AD8039 pinout for slow channel amp. Added 10nF capacitor to level out 5V supply; measured at 4.88V on corrected hardware. Added reverse protection diode to 5V from USB.
PSU Controller uC
Pi Connector & E2
IF LM2736Y
R2=1K
R3=330R
Power Supply (copied from the Arduino DUE)
JTAG/STLink
Slave SPI device; program directly or via SPI from main uC/Pi via address
Main uC
Note Pi Zero Header is flipped, the Pi Zero is inserted upside down.

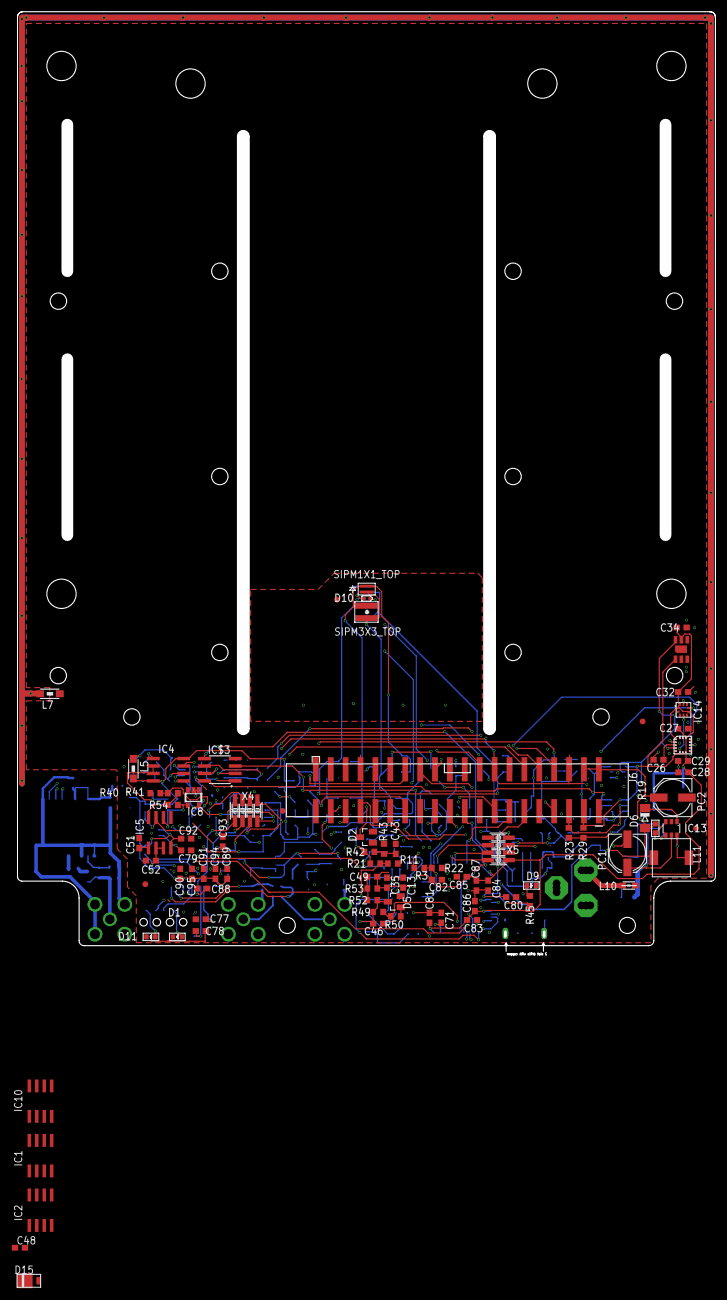
[picture p6: board Cosmic Pi V2.brd from above]

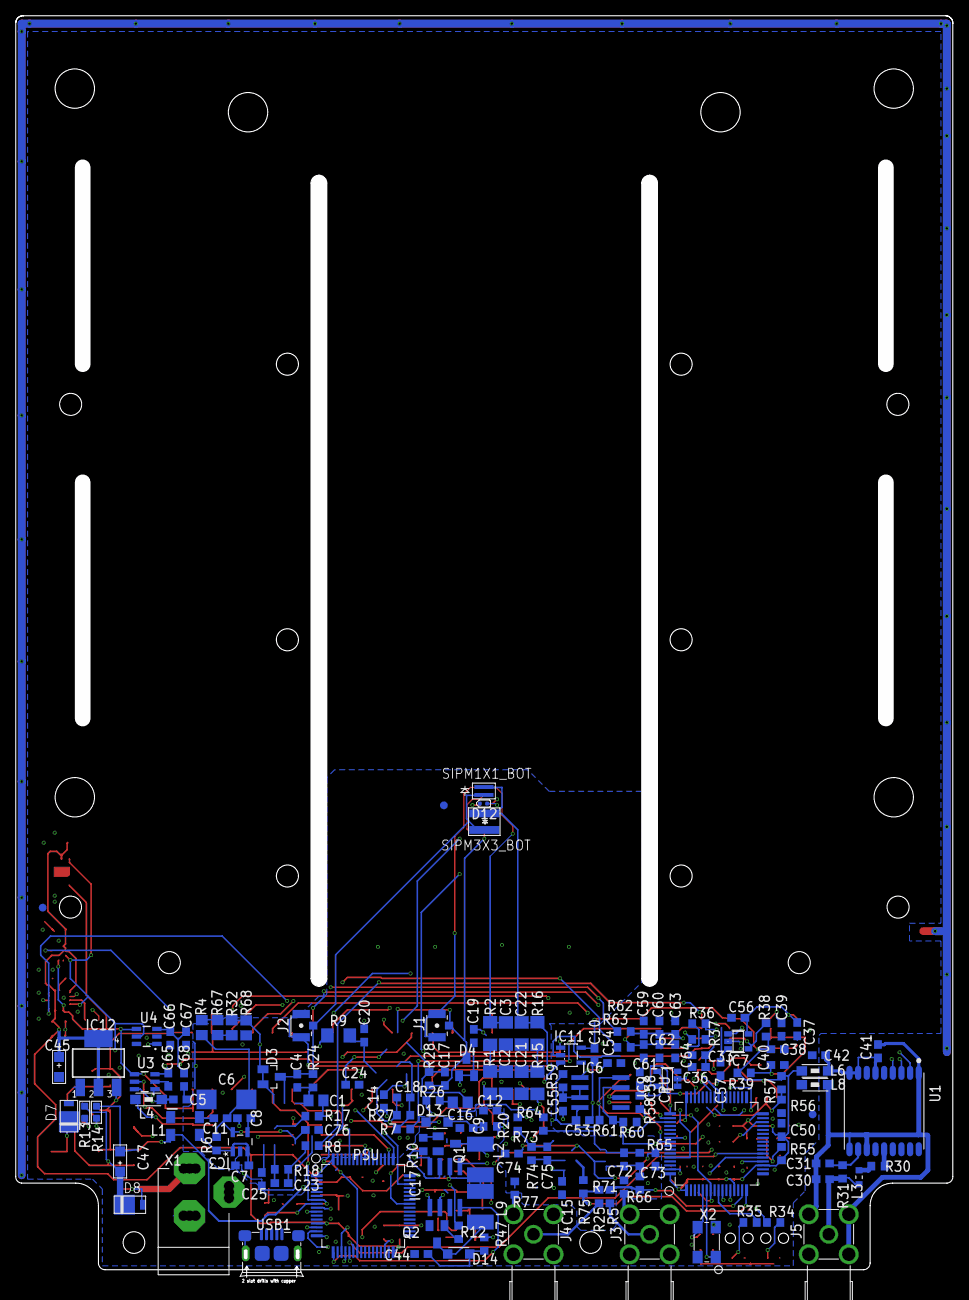
[picture p7: board Cosmic Pi V2.brd from below]

Board: 4 copper layers, 119.0 x 160.2 mm, 237 parts (151 on the bottom side), 139 nets.
