cosmic-pi-deprecated/Version2-HARDWARE/STM32configPSU.ioc

Mcu.UserName=STM32F401RETx
PA0-WKUP.Signal=S_TIM5_CH1
PA1.Signal=ADCx_IN1
PA2.Signal=ADCx_IN2
PA3.Signal=S_TIM5_CH4
PA4.Signal=SPI1_NSS
PA5.Signal=SPI1_SCK
PA6.Signal=SPI1_MISO
PA7.Signal=SPI1_MOSI
PA8.Signal=S_TIM1_CH1
PC0.GPIO_Label=PSULED
PC0.Signal=GPIO_Output
PC1.GPIO_Label=HV1EN
PC1.Signal=GPIO_Output
PC2.GPIO_Label=HV2EN
PC2.Signal=GPIO_Output
