cosmic-pi-deprecated/Version2-HARDWARE/(commit log)

2018-02-20 uploaded. Needs work.
    [Cosmic Pi V2.brd, Cosmic Pi V2.sch]
2018-03-21 Work in progress
    Added DACs.
    Tidied Sheet 1 - Analogue.
    Started Adding STM32's (one of two).
    To do: 1 - 1mm2 SiPM Footprint
    2 - Finish STM32s (2)
    3- Power regulator + jack
    [Cosmic Pi V2.brd, Cosmic Pi V2.sch]
2018-04-18 Current schematic in PDF format
2018-04-18 Updated schematic - nearly finished
    [Cosmic Pi V2.brd, Cosmic Pi V2.sch]
2018-04-28 PSU complete in schematic. CPU to do.
    [Cosmic Pi V2.sch, PSU_Pinout.csv]
2018-04-28 Schematic design completed.
    PSU + CPU outputs changed a little after reading the STM32 manual
    [CPU_Pinout.csv, Cosmic Pi V2.brd, Cosmic Pi V2.sch]
2018-04-30 schematic complete, layout tweaks and routing required
    [Cosmic Pi V2 BOM.csv, Cosmic Pi V2.brd, Cosmic Pi V2.sch, hole setting out.ods]
2018-04-30 Updated schematic. Components added for 1mm2 SiPMs
2018-05-03 Updated STM32MX cube files
    No external oscillator on PSU uC
    [PSU_Pinout.csv]
2018-07-22 Update following testing of 4 prototypes.
    Note .BRD isn't updated.
    [BOM master with extended info.xlsx, Cosmic Pi V2.brd, Cosmic Pi V2.sch]
2018-07-22 Updated STM32cube files
    fixed the configuration elements to match new schematic
    [STM32configCPU.ioc, STM32configPSU.ioc]
