cosmic-pi-deprecated/Version2-HARDWARE/(notices)

Notices in the files:
parts and their libraries:
EMCComponents: Copyright: Würth Elektronik
SparkFun-IC-Conversion: Licensing: Creative Commons ShareAlike 4.0 International - https://creativecommons.org/licenses/by-sa/4.0
